Sam3e2/Subosi/pcb/subosi.kicad_pcb

## KiCad design pcb/subosi.kicad_pcb (2022-01-25)

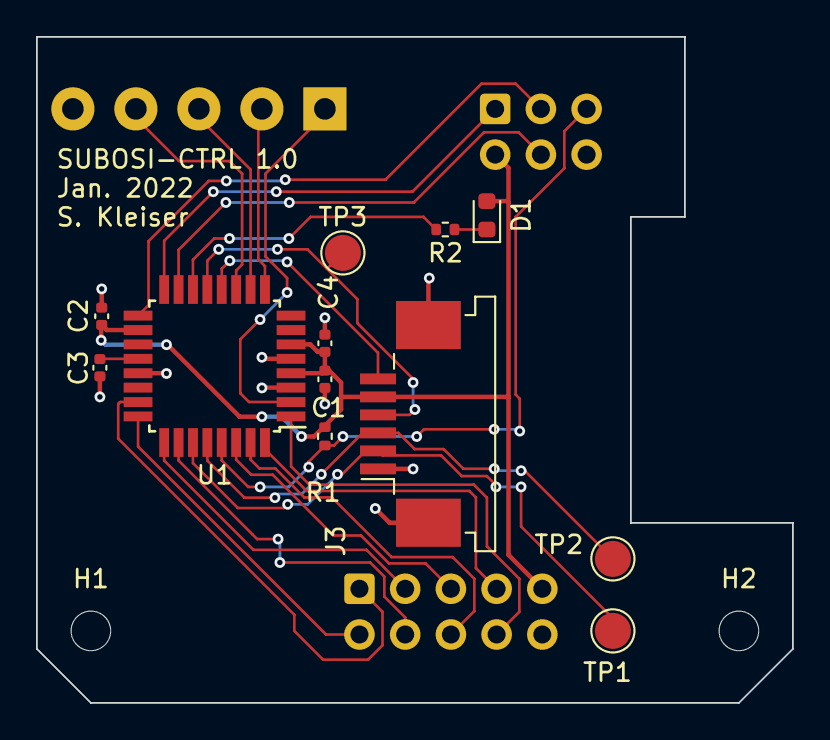
[picture p1: board subosi.kicad_pcb from above]

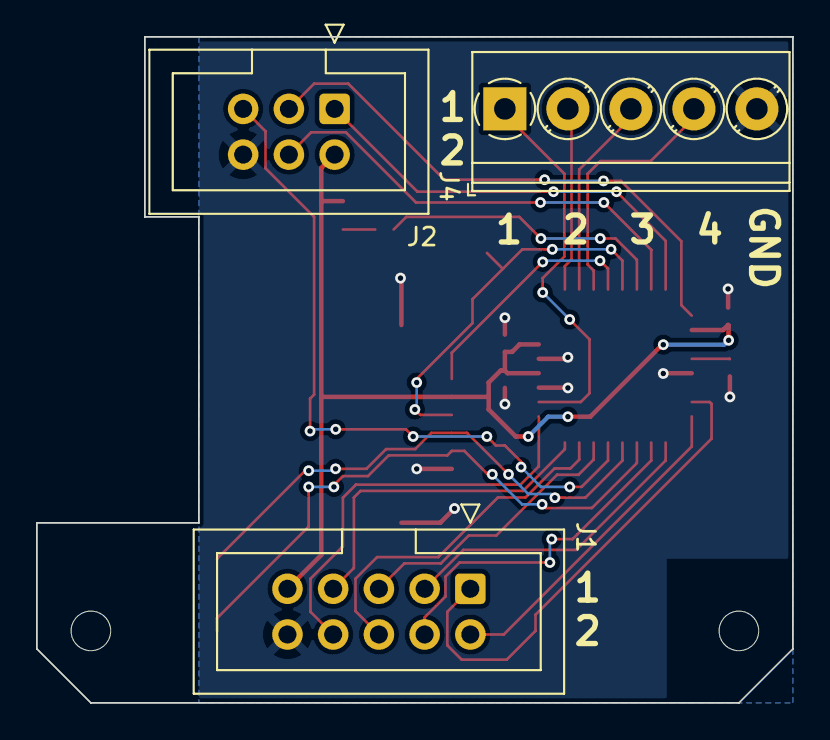
[picture p2: board subosi.kicad_pcb from below]

Board: 2 copper layers, 42.0 x 37.0 mm, 17 parts (3 on the bottom side), 25 nets.

Parts:
C1, C2, C3: 100n; C_0402_1005Metric
C4: 10u; C_0402_1005Metric
D1: LED; LED_0603_1608Metric
H1, H2: MountingHole; MountingHole_2.2mm_M2_ISO14580
J1: IO; IDC-Header_2x05_P2.54mm_Vertical
J2: AVR-ISP-6; IDC-Header_2x03_P2.54mm_Vertical
J3: Conn_01x06_MountingPin; TE_84953-6_1x06-1MP_P1.0mm_Horizontal
J4: IN; TerminalBlock_Phoenix_PT-1,5-5-3.5-H_1x05_P3.50mm_Horizontal
R1: 10k; R_0402_1005Metric
R2: 220; R_0402_1005Metric
TP1, TP2, TP3: TestPoint; TestPoint_Pad_D2.0mm
U1: ATmega48-20A; TQFP-32_7x7mm_P0.8mm

Connections:
/LED: J3.6, U1.12 (PB0)
/RST: J2.5 (~RST), R1.1, U1.29 (~RESET/PC6)
/SCL: J3.3, TP2.1, U1.28 (PC5)
/SDA: J3.2, TP1.1, U1.27 (PC4)
/WKUP: J3.4, TP3.1, U1.13 (PB1)
GND: C1.2, C2.2, C3.2, C4.2, J1.10, J2.6 (GND), J3.1, J3.MP (MountPin), J4.5, U1.3 (GND), U1.5 (GND), U1.21 (GND)
unnamed: C3.1, U1.20 (AREF)
unnamed: D1.1 (K), R2.1
unnamed: J1.1, U1.23 (PC0)
unnamed: J1.2, U1.24 (PC1)
unnamed: J1.3, U1.25 (PC2)
unnamed: J1.4, U1.26 (PC3)
unnamed: J1.5, U1.30 (PD0)
unnamed: J1.6, U1.31 (PD1)
unnamed: J1.7, U1.32 (PD2)
unnamed: J1.8, U1.1 (PD3)
unnamed: J2.1 (MISO), U1.16 (PB4)
unnamed: J2.3 (SCK), U1.17 (PB5)
unnamed: J2.4 (MOSI), U1.15 (PB3)
unnamed: J4.1, U1.2 (PD4)
unnamed: J4.2, U1.9 (PD5)
unnamed: J4.3, U1.10 (PD6)
unnamed: J4.4, U1.11 (PD7)
unnamed: R2.2, U1.14 (PB2)
VCC: C1.1, C2.1, C4.1, D1.2 (A), J1.9, J2.2 (VCC), J3.5, R1.2, U1.4 (VCC), U1.6 (VCC), U1.18 (AVCC)
